Jakelewis17/EE416_Palomar_Beta_Prototype/Hardware/Documentation/Palomar-Patient-Monitor-3D_PCB_zoomed.png

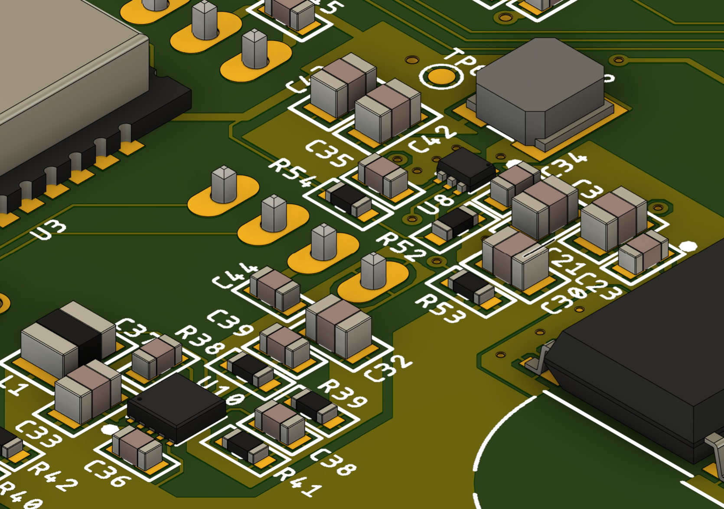
Hardware/Documentation/Palomar-Patient-Monitor-3D_PCB_zoomed.png
