Jakelewis17/EE416_Palomar_Beta_Prototype/Hardware/Documentation/blood pressure circuitry.jpg

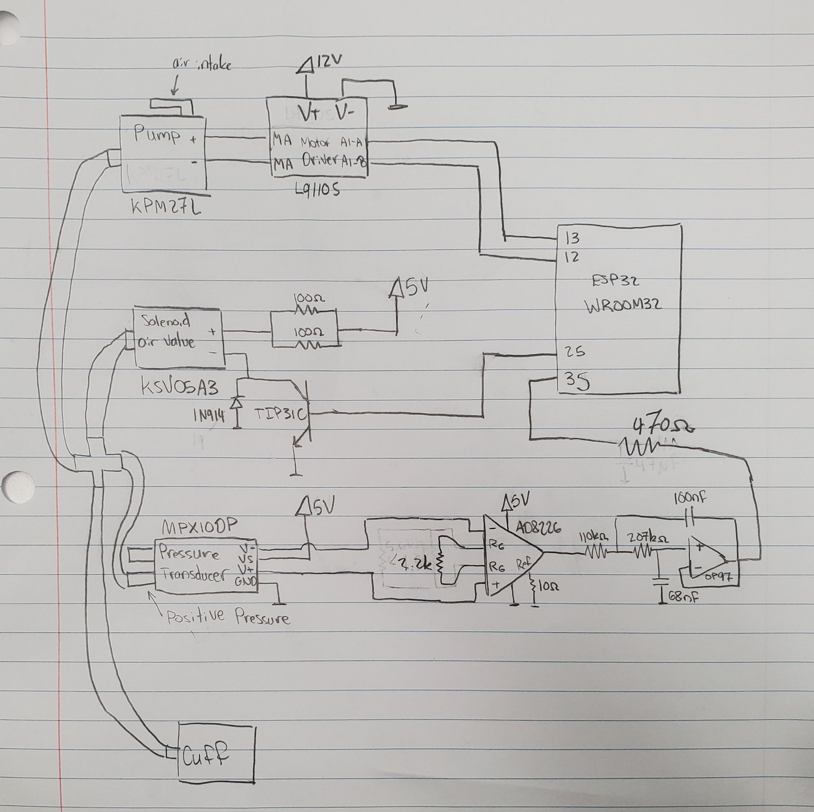
Hardware/Documentation/blood pressure circuitry.jpg
