Jakelewis17/EE416_Palomar_Beta_Prototype/Hardware/Documentation/ecg-sim-schematic.jpg

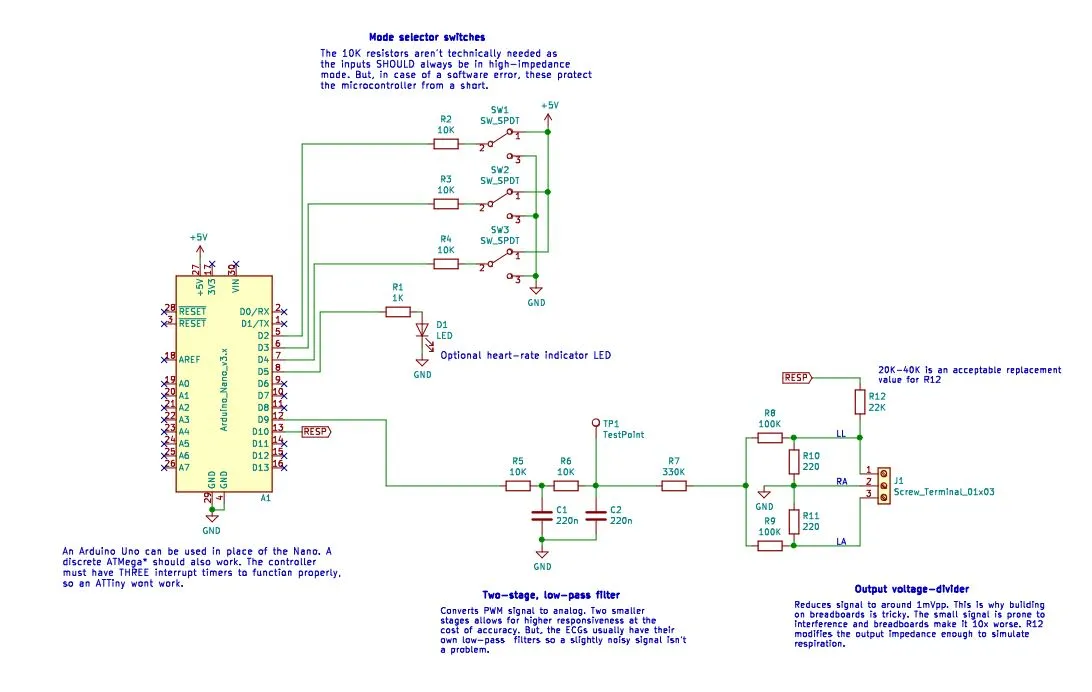
Hardware/Documentation/ecg-sim-schematic.jpg
