Jakelewis17/EE416_Palomar_Beta_Prototype/Software/Arduino_Cross-Correlation/cross_correlation_signal_80bpm.png

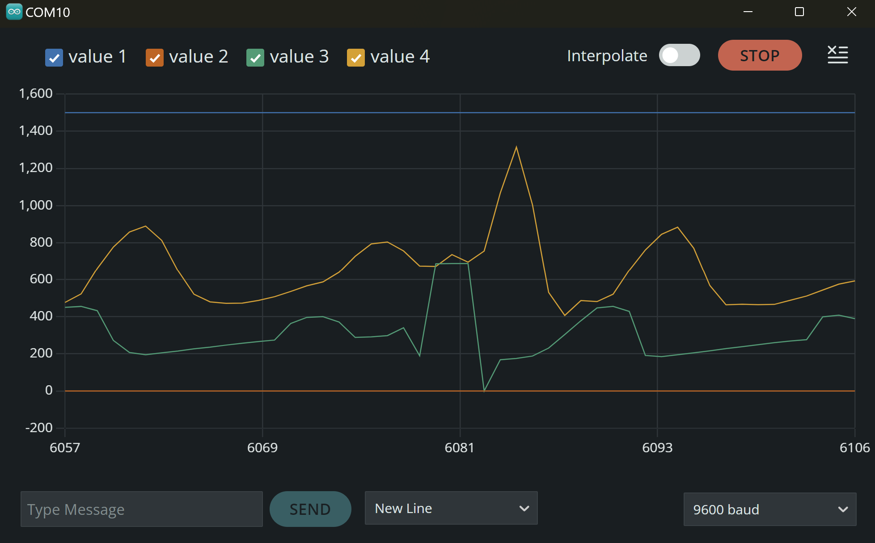
Software/Arduino_Cross-Correlation/cross_correlation_signal_80bpm.png
