Jakelewis17/EE416_Palomar_Beta_Prototype/Hardware/Documentation/Palomar-Patient-Monitor-Schematic.pdf

## Page 2

## Page 2

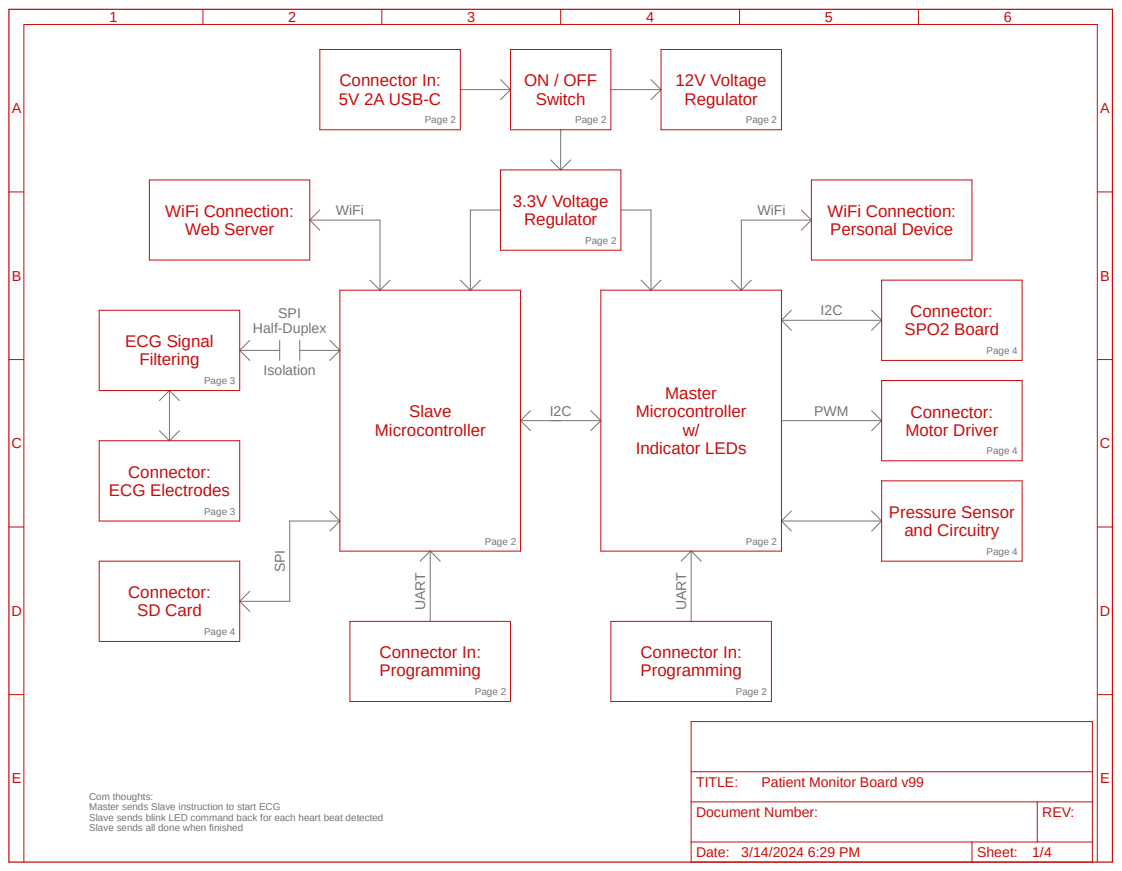
[picture p9: page 1]
SPI; Half-Duplex; PWM; WiFi; Isolation; Page 2; Page 3; I2C UART; UART; Page 4 SPI; Page 4; Master Microcontroller w/ Indicator LEDs; Connector: SPO2 Board; Connector: Motor Driver; Connector In: 5V 2A USB-C; 3.3V Voltage; Regulator; WiFi Connection:; Personal Device; Connector In: Programming; ON / OFF Switch; Connector: ECG Electrodes; Slave Microcontroller; WiFi Connection: Web Server; ECG Signal Filtering; Pressure Sensor and Circuitry; Connector: SD Card; 12V Voltage Regulator A; TITLE:

Patient Monitor Board v99

Com thoughts:
Master sends Slave instruction to start ECG
Slave sends blink LED command back for each heart beat detected
Slave sends all done when finished

Document Number: | REV:

Date: 3/14/2024 6:29 PM | Sheet: 1/4

## CAD Note: 10nF input capacitance required on either end of USB-C plug

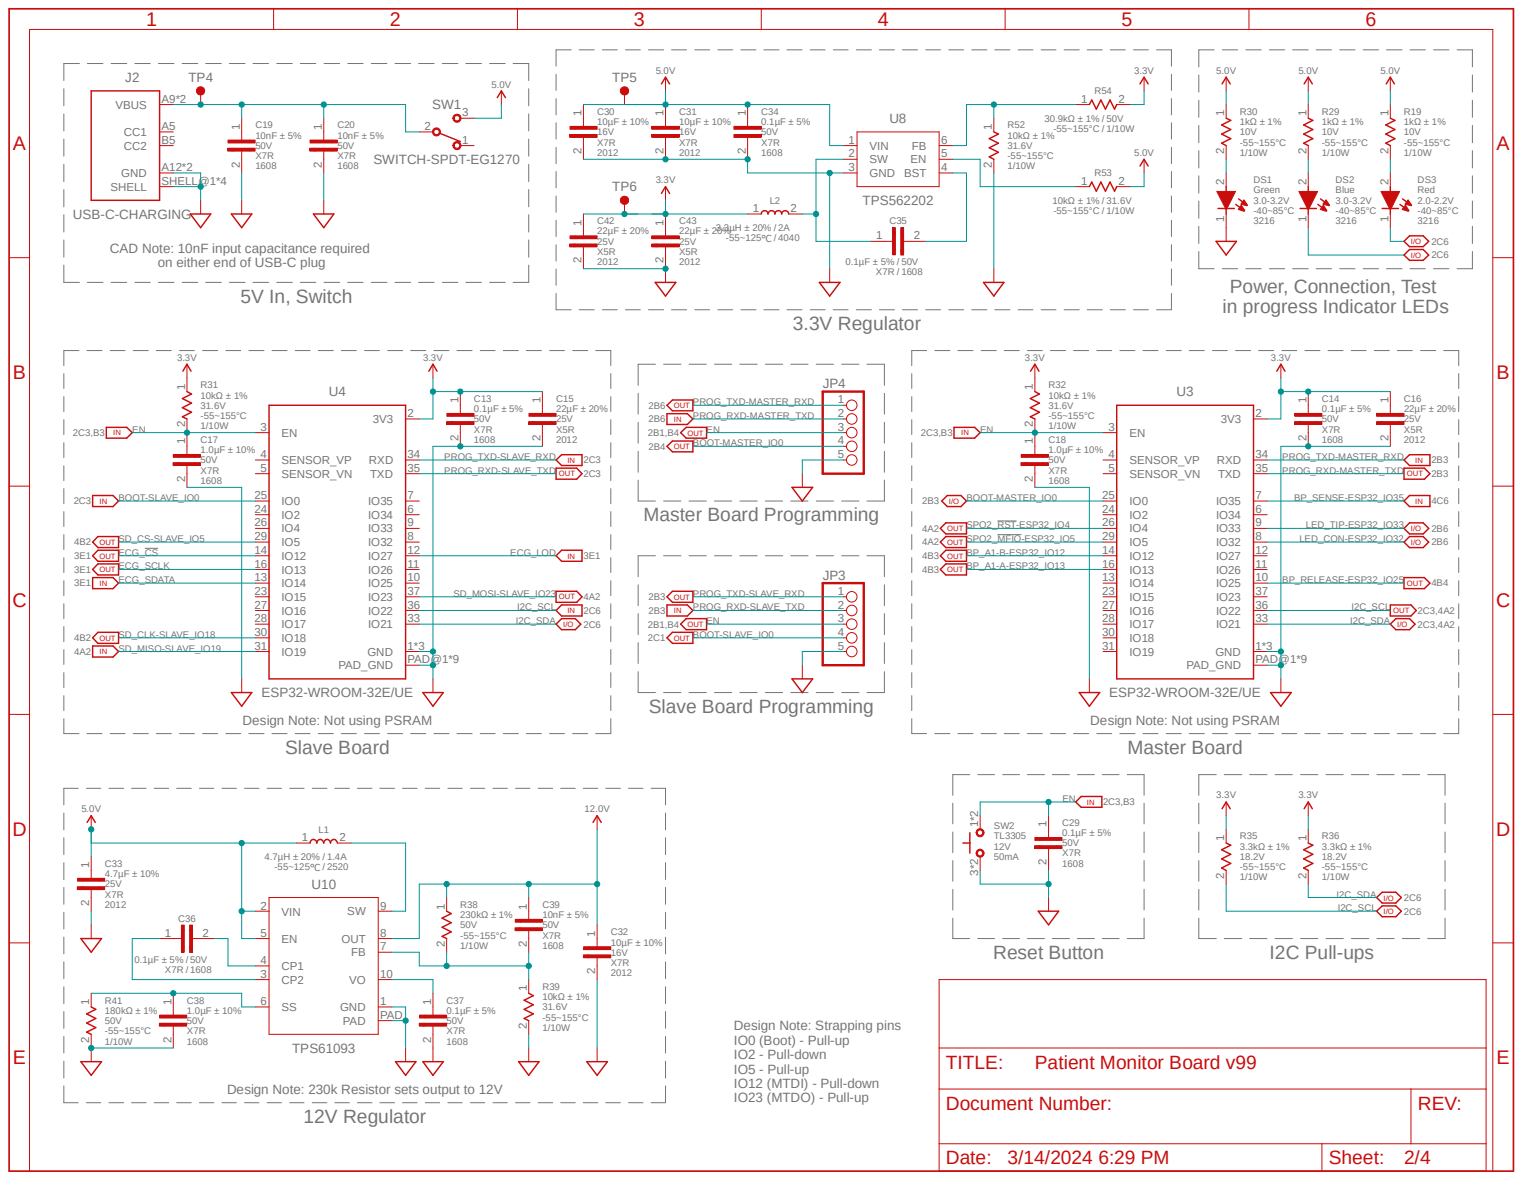
[picture p10: page 2]

Power, Connection, Test
in progress Indicator LEDs

Design Note: Not using PSRAM

Design Note: Strapping pins
IO0 (Boot) - Pull-up
IO2 - Pull-down
IO5 - Pull-up
IO12 (MTDI) - Pull-down
IO23 (MTDO) - Pull-up

Design Note: 230k Resistor sets output to 12V

High-pass Filter | Low-pass Filter

/ 50V

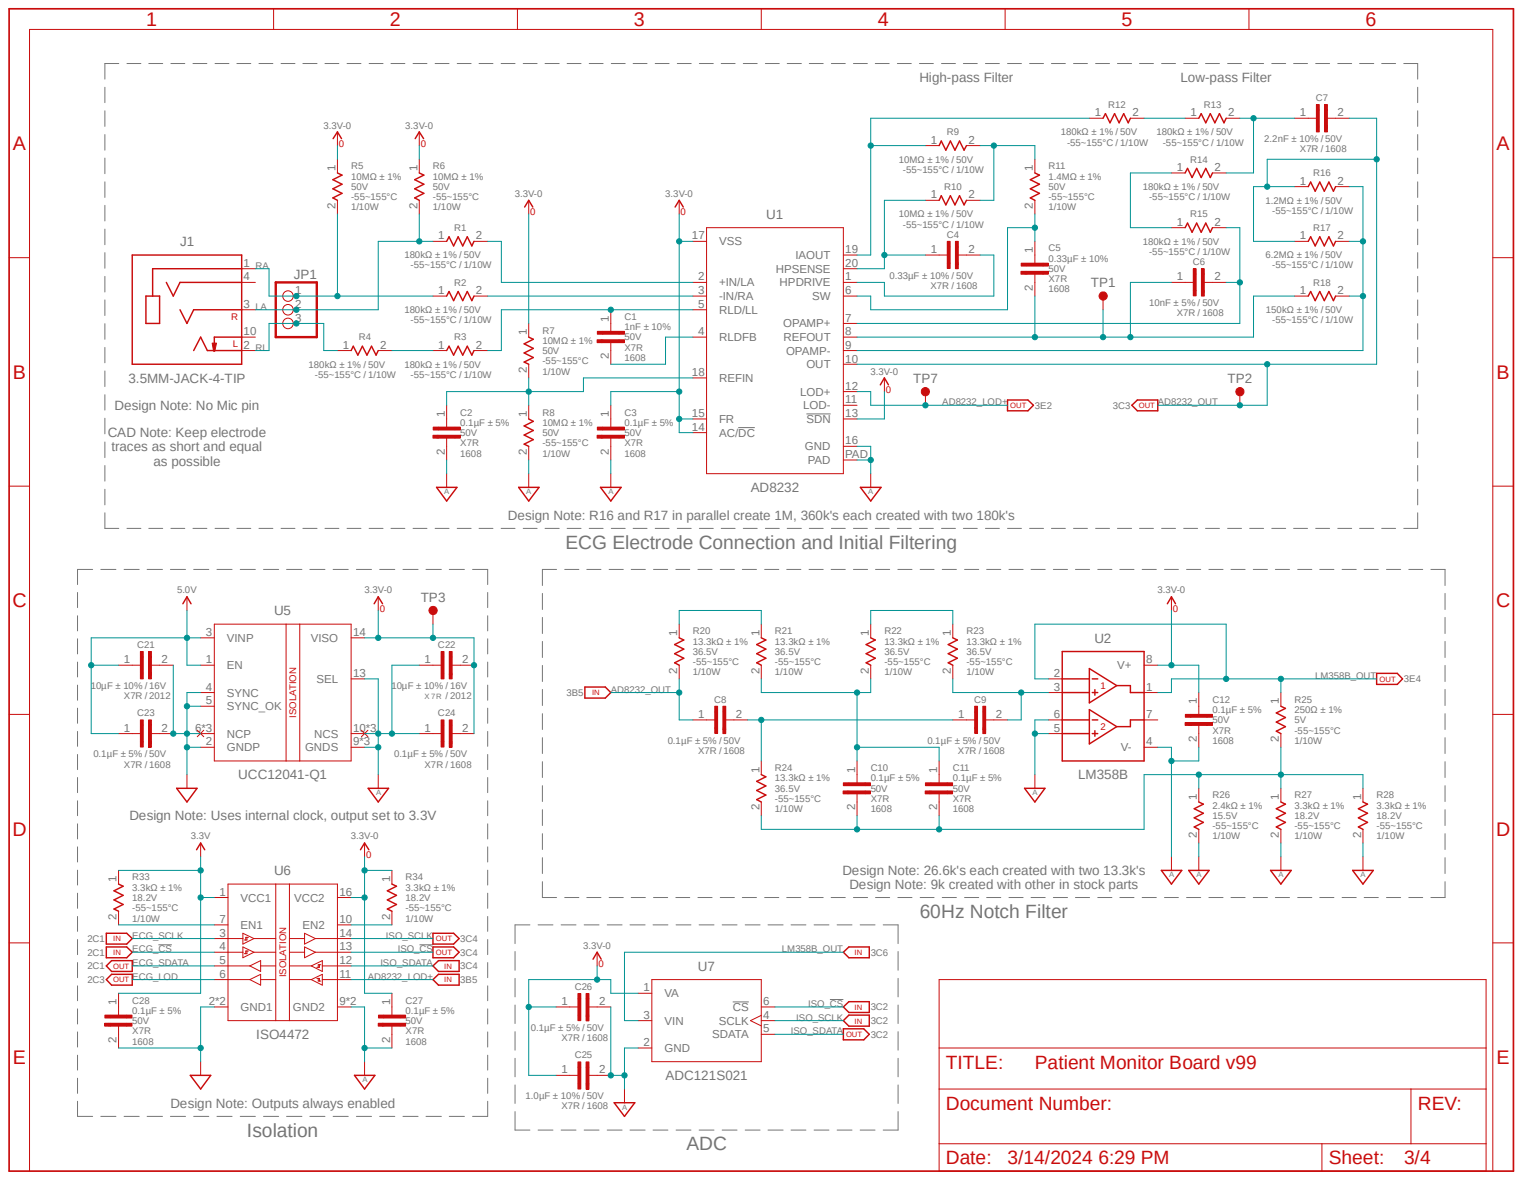
[picture p11: page 3]

3.5MM-JACK-4-TIP
Design Note: No Mic pin
CAD Note: Keep electrode
traces as short and equal
as possible

Design Note: R16 and R17 in parallel create 1M, 360k's each created with two 180k's
ECG Electrode Connection and Initial Filtering

Design Note: 26.6k's each created with two 13.3k's ³B5

Design Note: Uses internal clock, output set to 3.3V

Design Note: 9k created with other in stock parts

Design Note: Outputs always enabled

# 2C3 Micro SD Connector

## Design Note: CMD and Data lines must have 10k pull-ups 2C1

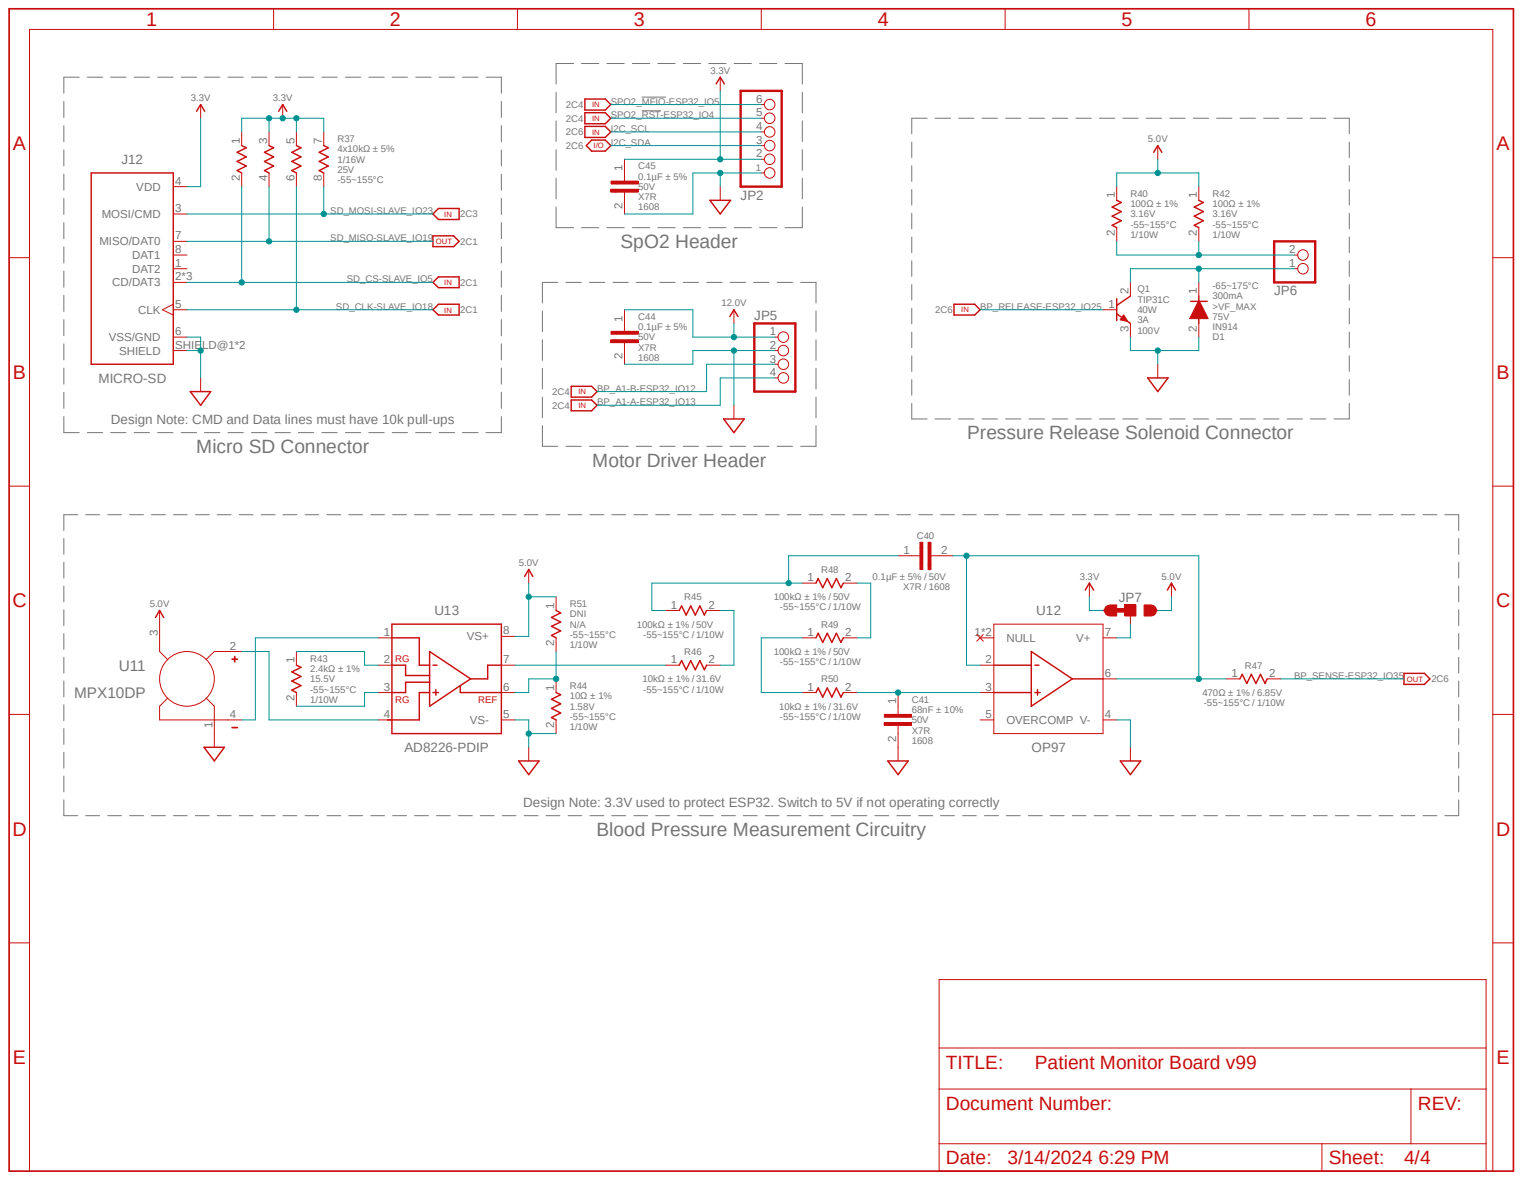
[picture p12: page 4]

Pressure Release Solenoid Connector ²C6

Design Note: 3.3V used to protect ESP32. Switch to 5V if not operating correctly

Blood Pressure Measurement Circuitry
