Jakelewis17/EE416_Palomar_Beta_Prototype/Hardware/Design-Files/Simulations/100Hz_LPF.asc

C1: cap; 1.5n
C2: cap; 10n
C3: cap; 10n
C4: cap; 1.5n
R1: res; 470k
R2: res; 470k
R3: res; 1Meg
R4: res; 100k
R5: res; 1Meg
R6: res; 1Meg
R7: res; 470k
R8: res; 470k
U1: LT1078
U2: LT1078
V2: voltage; 3.3
Vin: voltage; ""; AC 100mV
Named nets: 0, 3.3V, Vin, Vref, Vout, Vout1
.ac dec 50 0.1Hz 1000Hz
