Jakelewis17/EE416_Palomar_Beta_Prototype/Hardware/Design-Files/Simulations/60Hz_Notch_Filter.asc

2C1: cap; 0.2µ
C1: cap; 0.1µ
C2: cap; 0.1µ
R1/2: res; 13.25k
R1: res; 26.5k
R2: res; 26.5k
R3: res; 250
R4: res; 10k
U1: LT1078
Vcc: voltage; 3.3V
Vin: voltage; 1.65; AC 1V
Named nets: 0, 3.3V, Vout, Vin, Vp
.ac dec 50 0.1 1000
f = 60Hz, C = 0.1uF
R = 1/(2pi*f*C) = 26.5k
Choose Q = 10
k = R4/(R3+R4) = 1 - 1/(4Q) = 0.975
Let R4 = 10k, R3 = R4 - k*R4 = 250
