Jakelewis17/EE416_Palomar_Beta_Prototype/Hardware/Design-Files/Simulations/60Hz_Notch_Filter_Scott.asc

2C1: cap; {2*C}
C1: cap; {C}
C2: cap; {C}
E1: e; 1
R1/2: res; {R/2}
R1: res; {R}
R2: res; {R}
Rf: res; {Rf}
Rsh: res; {Rf*(4*Q-1)}
Vcc: voltage; 3.3V
Vin: voltage; ""; AC 1V
Named nets: 0, 3.3V, Vout, Vin, Vp
.ac dec 100 0.1 1000
f = 1/6.28*R*C)  Set to 60Hz
Set C, then adjust R
Choose Q = 10
 
4*Q = (1+Rsh/Rf)
Rf*(4*Q-1) = Rsh
R = 1/(6.28*F*C)
.param Fc=60 Q=10 R=26.5K C=100n Rf=249
