Jakelewis17/EE416_Palomar_Beta_Prototype/Hardware/Design-Files/Simulations/Full_ECG_Filter.asc

Buffer: e; 1
C1: cap; {C}
C1_HPF: cap; {C_HPF}
C1_LPF1: cap; {C1_LPF}
C1_LPF: cap; {C1_LPF}
C2: cap; {C}
C2_HPF: cap; {C_HPF}
C2_LPF1: cap; {C2_LPF}
C2_LPF: cap; {C2_LPF}
C3: cap; {2*C}
C4: cap; {2*C}
C5: cap; {C}
C6: cap; {C}
C11: cap; {C}
C21: cap; {C}
C31: cap; {2*C}
E1: e; 10000
E2: e; 1
R1: res; {R}
R1_HPF: res; {R_HPF}
R1_LPF1: res; {R_LPF}
R1_LPF: res; {R_LPF}
R2: res; {R}
R2_HPF: res; {R_HPF}
R2_LPF1: res; {R_LPF}
R2_LPF: res; {R_LPF}
R3: res; {R/2}
R3_HPF: res; 10k
R3_LPF1: res; 1Meg
R3_LPF2: res; 6.2Meg
R3_LPF: res; 1.2Meg
R4: res; {R/2}
R4_HPF: res; 20k
R4_LPF1: res; 100k
R4_LPF: res; 150k
R5: res; {R}
R6: res; {R}
R11: res; {R}
R21: res; {R}
R31: res; {R/2}
Rf1: res; {Rf}
Rf2: res; {Rf}
Rf: res; {Rf}
RGf: res; {RGf}
RGs: res; {RGs}
Rsh1: res; {Rf*(4*Q-1)}
Rsh2: res; {Rf*(4*Q-1)}
Rsh: res; {Rf*(4*Q-1)}
U1: LT1078
U2: LT1078
U3: LT1078
U5: LT1078
U6: LT1078
Vcc1: voltage; 3.3V
Vin3: voltage; 1.65; AC 1V
Vin4: voltage; 1.65V; AC 100mV
Vin: voltage; 1.65; AC 1m
Vref: voltage; 1.65V
Named nets: 0, 3.3V, Vout, IAOUT, REFOUT, Vout_LPF, Vg, Vout_4p
.ac dec 100 0.1 1000
.param Fc=60 Q=10 R=26.5K C=100n Rf=250
.param C_HPF=0.33u R_HPF=1Meg Rcomp=1.4Meg
.param R_LPF=360k C1_LPF=2.2n C2_LPF=10n
Low-pass Filter
Fc ~= 1/(2pi*sqrt(R1*C1*R2*C2) = 87Hz
Sim shows Fc ~= 105Hz
G = 1 + R3/R4 = 11
Notch Filter
Fn = 1/(6.28*R*C), Set to 60Hz
Choose C = 100nF -> R = 26.5K
4Q = 1 + Rsh/Rf -> Rsh = Rf*(4Q - 1)
Choose Q = 10, Rf = 250
.param RGf=60k RGs=1k
Model of Internal Gain
G = RGf/RGs = 100
Model of 2-pole High-pass Filter
Fc ~= 1/(2pi*sqrt(R1*C1*R2*C2) = 0.48Hz
Notch Filter 4-Pole
Vout
