Jakelewis17/EE416_Palomar_Beta_Prototype/Hardware/Design-Files/Simulations/Full_ECG_Transient.asc

Buffer1: e; 1
C1: cap; {C2_LPF}
C2: cap; {C1_LPF}
C3: cap; {2*C}
C4: cap; {C}
C5: cap; {C}
C6: cap; {C_HPF}
C7: cap; {C_HPF}
R1: res; 1.2Meg
R2: res; 150k
R3: res; {R_LPF}
R4: res; {R_LPF}
R5: res; {R/2}
R6: res; {R}
R7: res; {R}
R8: res; {R_HPF}
R9: res; {R_HPF}
R10: res; 10k
R11: res; 20k
R12: res; 6.2Meg
Rf1: res; {Rf}
RGf1: res; {RGf}
RGs1: res; {RGs}
Rsh1: res; {Rf*(4*Q-1)}
U1: LT1078
U2: LT1078
U3: LT1078
U4: LT1078
Vcc1: voltage; 3.3V
Vin1: voltage; SINE(1.65 1m 10)
Vin2: voltage; SINE(1.65 100m 10)
Vin3: voltage; SINE(1.65 100m 10)
Vin4: voltage; SINE(1.65 0.7 10)
Vref1: voltage; 1.65V
Named nets: 0, 3.3V, Vout, IAOUT, REFOUT, Vout_LPF, Vg
.tran 0 500m 0
.param Fc=60 Q=10 R=26.5K C=100n Rf=250
.param C_HPF=0.33u R_HPF=1Meg Rcomp=1.4Meg
.param R_LPF=380k C1_LPF=2.2n C2_LPF=10n
Low-pass Filter
Fc ~= 1/(2pi*sqrt(R1*C1*R2*C2) = 87Hz
Sim shows Fc ~= 105Hz
G = 1 + R3/R4 = 11
Notch Filter
Fn = 1/(6.28*R*C), Set to 60Hz
Choose C = 100nF -> R = 26.5K
4Q = 1 + Rsh/Rf -> Rsh = Rf*(4Q - 1)
Choose Q = 10, Rf = 250
.param RGf=100k RGs=1k
Model of Internal Gain
G = RGf/RGs = 100
Model of 2-pole High-pass Filter
Fc ~= 1/(2pi*sqrt(R1*C1*R2*C2) = 0.48Hz
Sim shows Fc ~= 105Hz
