Jakelewis17/EE416_Palomar_Beta_Prototype/(commit log)

2024-03-01 Added patient data struct and got it set up for sending to other esp
2024-03-01 Added patient data struct and functions to send to other esp
2024-03-21 Added PCB files
2024-04-01 Removed TFT Display and Rotary Encoder control
2024-04-07 Debounced the send data button in Blynk app
2024-04-08 Test code for verifying programming boards and ECG
2024-04-09 More progress ... still doesn't work
    [ecg.cpp, main.cpp, patient_monitor.h]
2024-04-09 More progress, still doesn't work
    [main.cpp, patient_monitor.h]
2024-04-15 Updated to send data from the ESP32 to the server.
2024-04-15 Updated the ECG code to work with the Esp32
2024-04-16 I2C Comms from Slave to Master
